lampwriter/battery7s6p/renders/bot_1oz_board_bottom.png

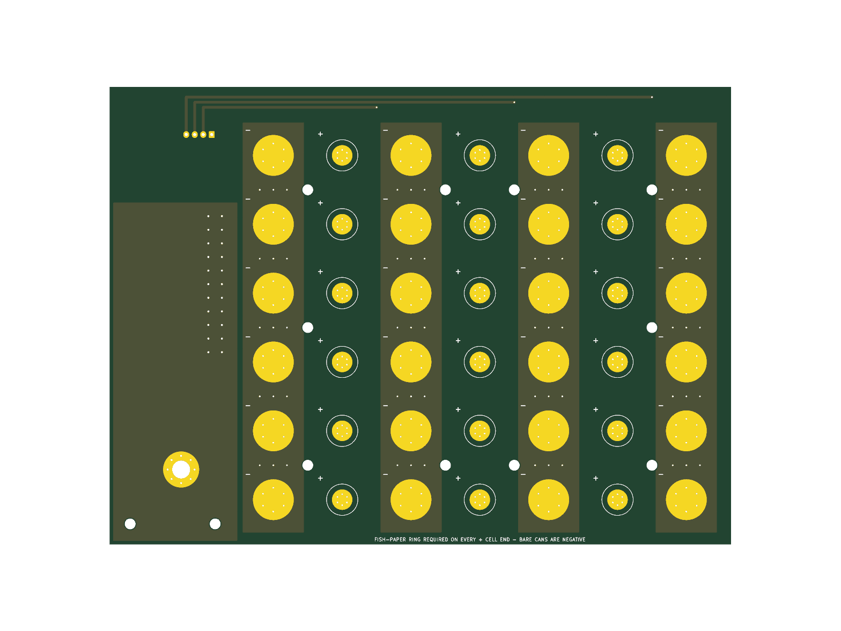
renders/bot_1oz_board_bottom.png
