lampwriter/battery7s6p/renders/bot_1oz_board_top.png

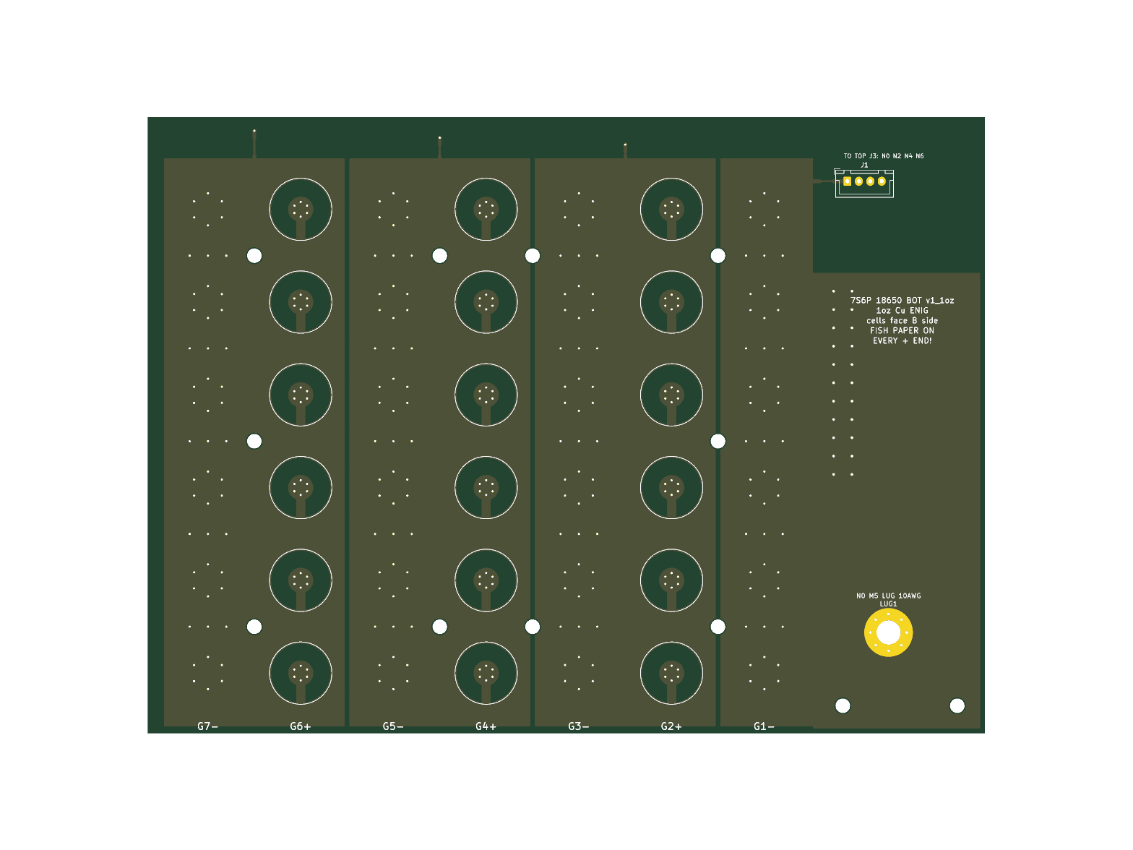
renders/bot_1oz_board_top.png
