lampwriter/battery7s6p/renders/bot_v12_board_bottom.png

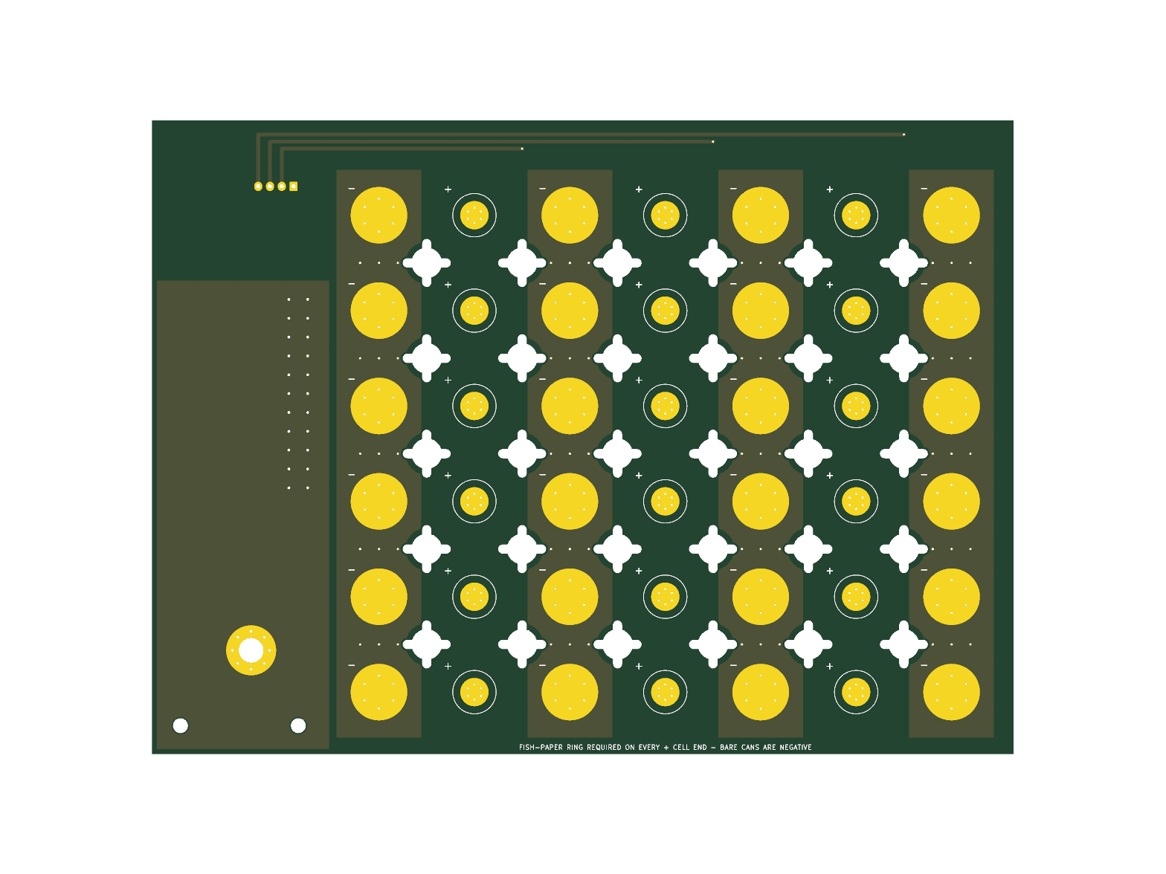
renders/bot_v12_board_bottom.png
