lampwriter/battery7s6p/renders/bot_v12_board_top.png

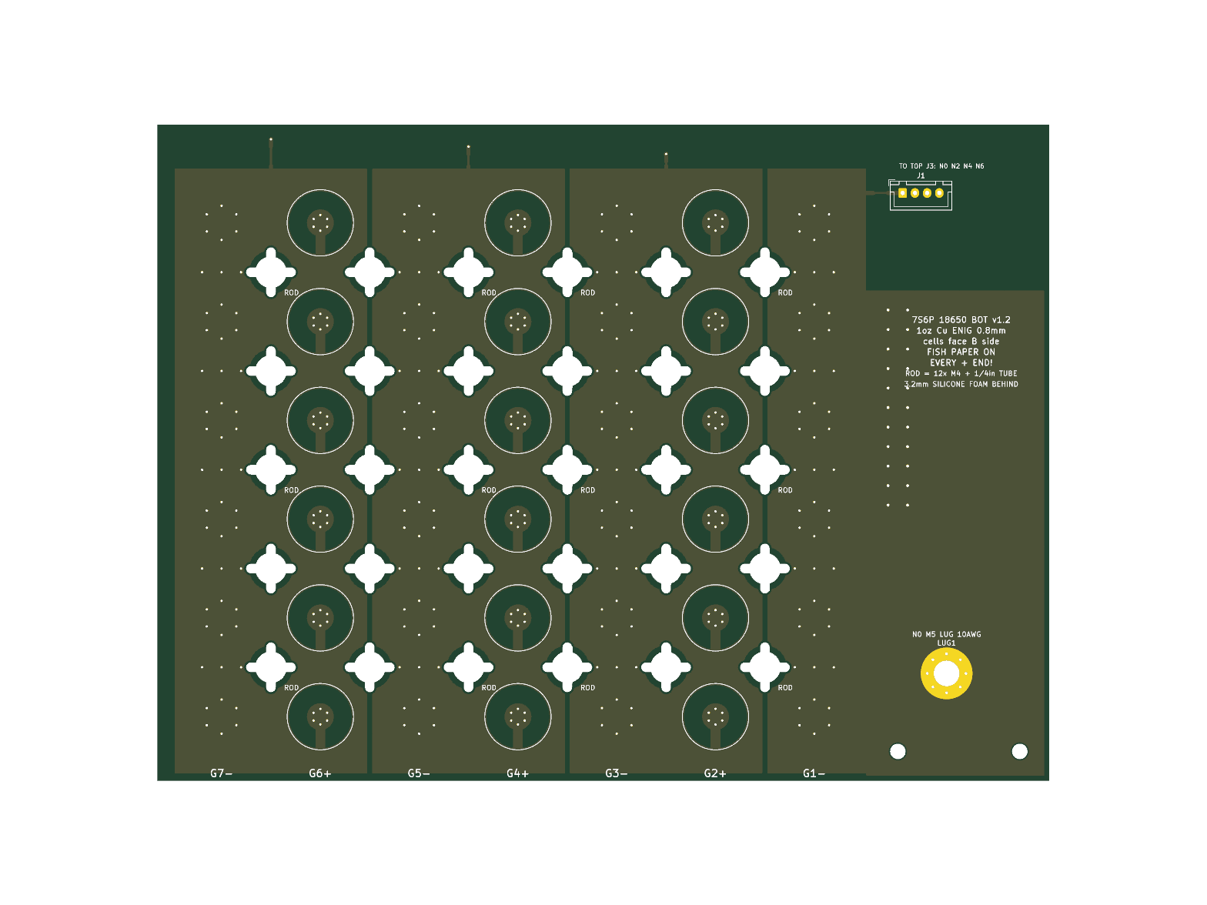
renders/bot_v12_board_top.png
