lampwriter/battery7s6p/renders/top_1oz_board_bottom.png

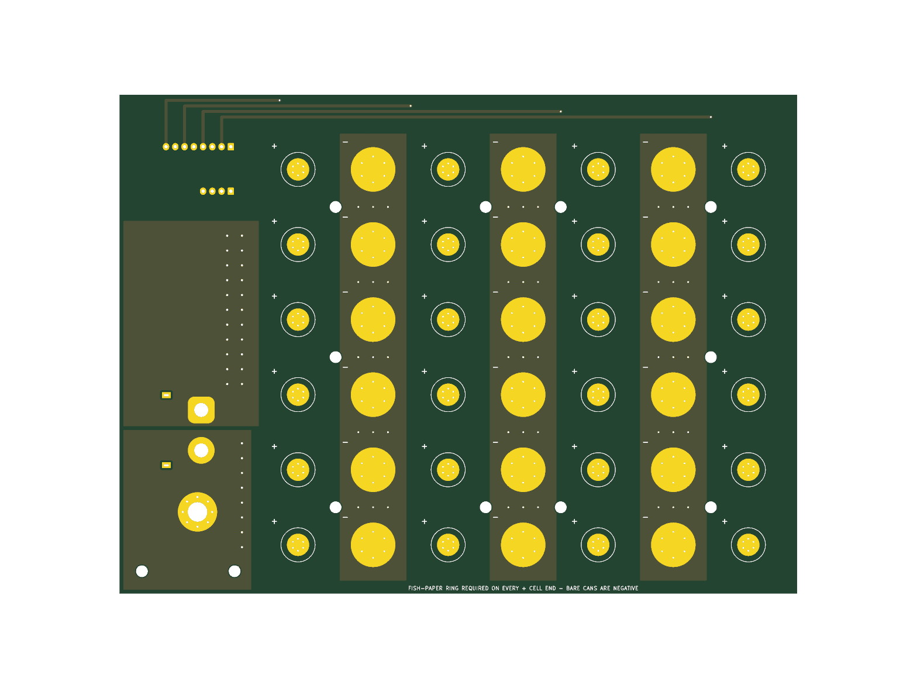
renders/top_1oz_board_bottom.png
