lampwriter/battery7s6p/renders/top_1oz_board_top.png

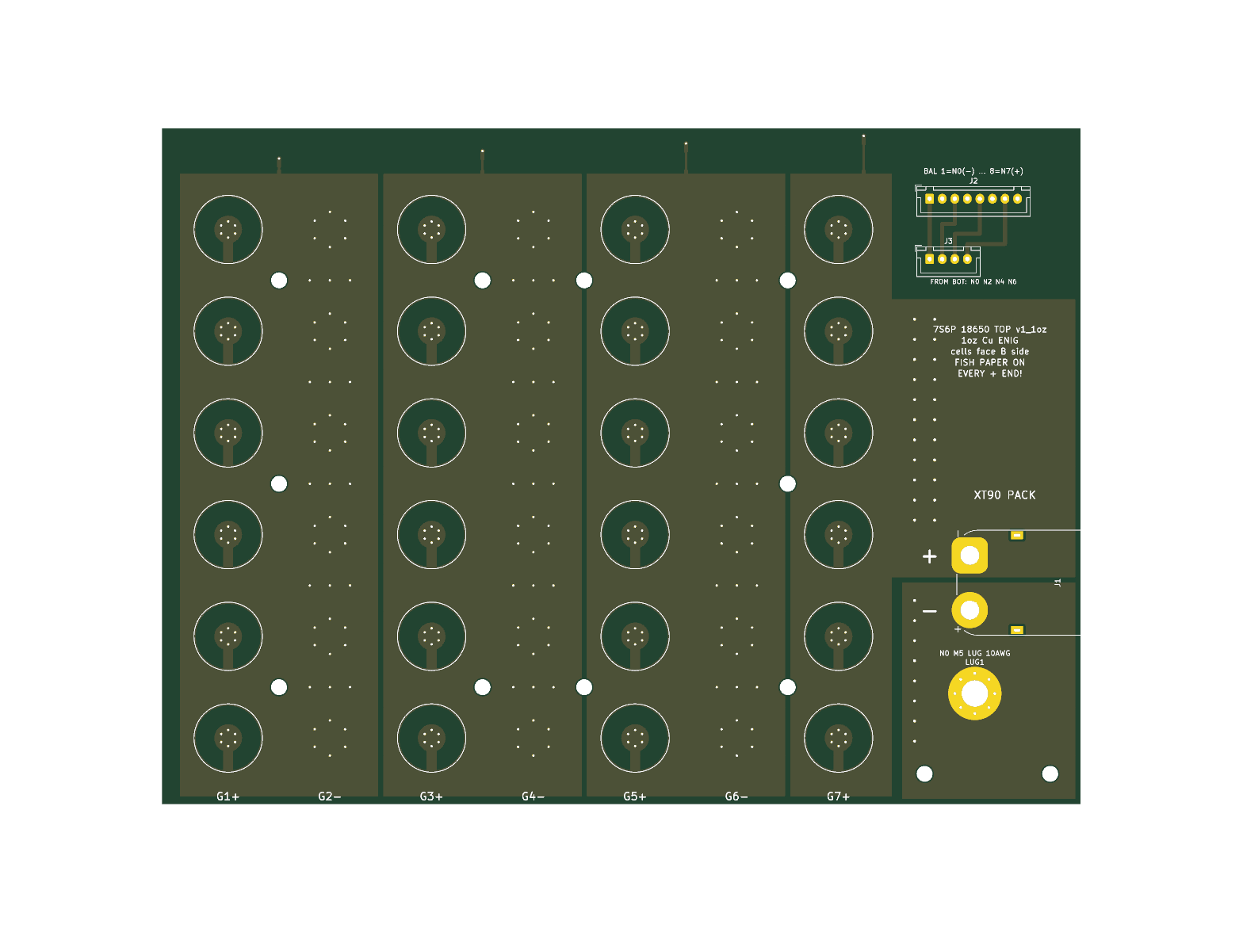
renders/top_1oz_board_top.png
