lampwriter/battery7s6p/renders/top_v12_board_bottom.png

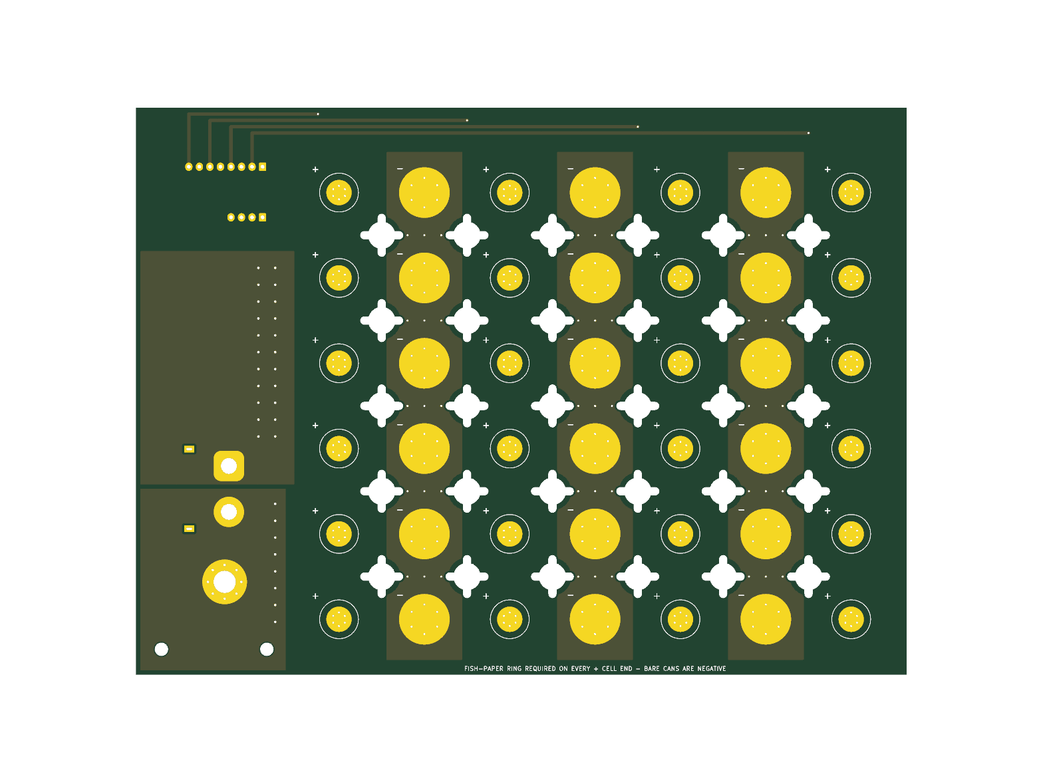
renders/top_v12_board_bottom.png
