lampwriter/battery7s6p/fab_v12/battery7s6p_bot_v12_BOM_JLCPCB.csv

Comment | Designator | Footprint | LCSC Part #
JST B4B-XH-A(LF)(SN) | J1 | JST_XH_B4B-XH-A_1x04_P2.50mm_Vertical | C144395
