lampwriter/battery7s6p/fab_v12/battery7s6p_top_v12_BOM_JLCPCB.csv

Comment | Designator | Footprint | LCSC Part #
AMASS XT90PW-M (XT90 PCB male, right-angle) | J1 | AMASS_XT90PW-M_1x02_P10.90mm_Horizontal | C3040689
JST B8B-XH-A(LF)(SN) | J2 | JST_XH_B8B-XH-A_1x08_P2.50mm_Vertical | C157972
JST B4B-XH-A(LF)(SN) | J3 | JST_XH_B4B-XH-A_1x04_P2.50mm_Vertical | C144395
