lampwriter/battery7s6p/fab_v12/battery7s6p_v12_drill_template.dxf

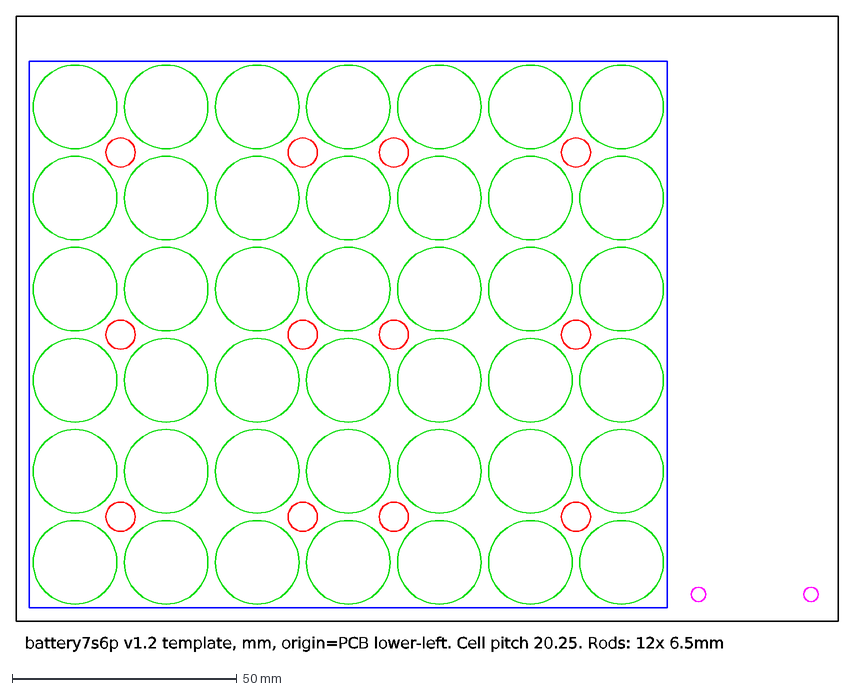
[picture p8: CAD file, 2026-11-01]
fab_v12/battery7s6p_v12_drill_template.dxf
battery7s6p v1.2 template, mm, origin=PCB lower-left. Cell pitch 20.25. Rods: 12x 6.5mm
