lampwriter/battery7s6p/bot_v12/battery7s6p_bot_v12.kicad_pcb

## KiCad design bot_v12/battery7s6p_bot_v12.kicad_pcb (2026-11-01)

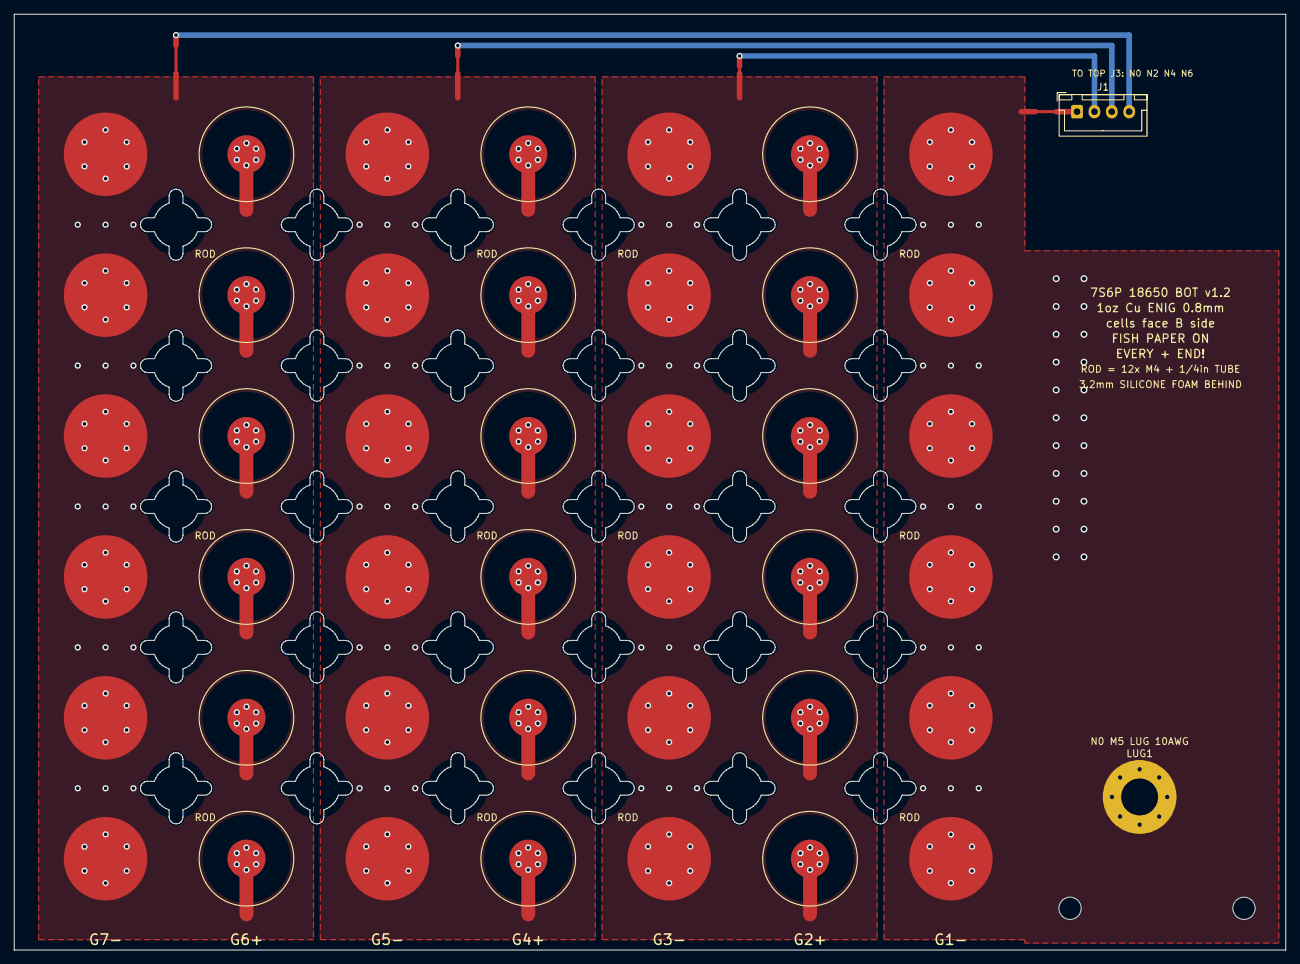
[picture p9: board battery7s6p_bot_v12.kicad_pcb from above]

Board: 2 copper layers, 182.8 x 134.5 mm, 46 parts (0 on the bottom side), 4 nets.

Parts:
C1_1, C1_2, C1_3, C1_4, C1_5, C1_6, C3_1, C3_2, C3_3, C3_4, C3_5, C3_6, C5_1, C5_2, C5_3, C5_4, C5_5, C5_6, C7_1, C7_2, C7_3, C7_4, C7_5, C7_6: 18650_NEG; CELL_NEG_CONTACT
C2_1, C2_2, C2_3, C2_4, C2_5, C2_6, C4_1, C4_2, C4_3, C4_4, C4_5, C4_6, C6_1, C6_2, C6_3, C6_4, C6_5, C6_6: 18650_POS; CELL_POS_CONTACT
HT0, HT1: MountingHole_3.2mm_M3
J1: B4B-XH-A to TOP; JST_XH_B4B-XH-A_1x04_P2.50mm_Vertical
LUG1: N0 M5 LUG; MountingHole_5.3mm_M5_Pad_Via

Connections:
N0: C1_1.1, C1_2.1, C1_3.1, C1_4.1, C1_5.1, C1_6.1, J1.1, LUG1.1
N2: C2_1.1, C2_2.1, C2_3.1, C2_4.1, C2_5.1, C2_6.1, C3_1.1, C3_2.1, C3_3.1, C3_4.1, C3_5.1, C3_6.1, J1.2
N4: C4_1.1, C4_2.1, C4_3.1, C4_4.1, C4_5.1, C4_6.1, C5_1.1, C5_2.1, C5_3.1, C5_4.1, C5_5.1, C5_6.1, J1.3
N6: C6_1.1, C6_2.1, C6_3.1, C6_4.1, C6_5.1, C6_6.1, C7_1.1, C7_2.1, C7_3.1, C7_4.1, C7_5.1, C7_6.1, J1.4
