lampwriter/battery7s6p/top_v12/battery7s6p_top_v12.kicad_pcb

## KiCad design top_v12/battery7s6p_top_v12.kicad_pcb (2026-11-01)

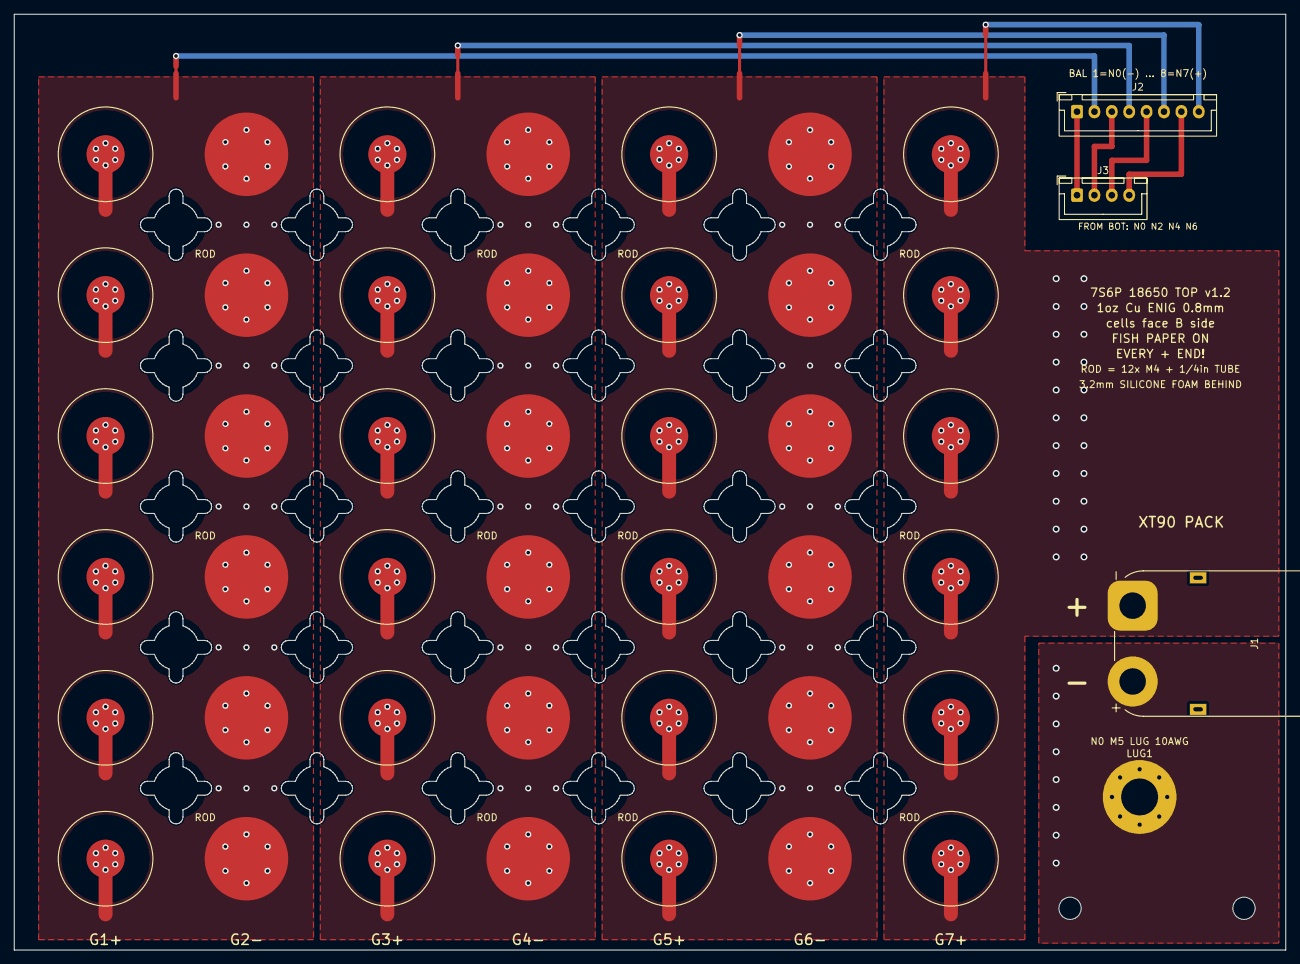
[picture p10: board battery7s6p_top_v12.kicad_pcb from above]

Board: 2 copper layers, 182.8 x 134.5 mm, 48 parts (0 on the bottom side), 9 nets.

Parts:
C1_1, C1_2, C1_3, C1_4, C1_5, C1_6, C3_1, C3_2, C3_3, C3_4, C3_5, C3_6, C5_1, C5_2, C5_3, C5_4, C5_5, C5_6, C7_1, C7_2, C7_3, C7_4, C7_5, C7_6: 18650_POS; CELL_POS_CONTACT
C2_1, C2_2, C2_3, C2_4, C2_5, C2_6, C4_1, C4_2, C4_3, C4_4, C4_5, C4_6, C6_1, C6_2, C6_3, C6_4, C6_5, C6_6: 18650_NEG; CELL_NEG_CONTACT
HT0, HT1: MountingHole_3.2mm_M3
J1: XT90PW-M; AMASS_XT90PW-M_1x02_P10.90mm_Horizontal
J2: B8B-XH-A BAL; JST_XH_B8B-XH-A_1x08_P2.50mm_Vertical
J3: B4B-XH-A from BOT; JST_XH_B4B-XH-A_1x04_P2.50mm_Vertical
LUG1: N0 M5 LUG; MountingHole_5.3mm_M5_Pad_Via

Connections:
N0: J1.2, LUG1.1
N0_SENSE: J2.1, J3.1
N1: C1_1.1, C1_2.1, C1_3.1, C1_4.1, C1_5.1, C1_6.1, C2_1.1, C2_2.1, C2_3.1, C2_4.1, C2_5.1, C2_6.1, J2.2
N2: J2.3, J3.2
N3: C3_1.1, C3_2.1, C3_3.1, C3_4.1, C3_5.1, C3_6.1, C4_1.1, C4_2.1, C4_3.1, C4_4.1, C4_5.1, C4_6.1, J2.4
N4: J2.5, J3.3
N5: C5_1.1, C5_2.1, C5_3.1, C5_4.1, C5_5.1, C5_6.1, C6_1.1, C6_2.1, C6_3.1, C6_4.1, C6_5.1, C6_6.1, J2.6
N6: J2.7, J3.4
N7: C7_1.1, C7_2.1, C7_3.1, C7_4.1, C7_5.1, C7_6.1, J1.1, J2.8
