lampwriter/battery7s6p/(commit log)

2026-10-28 Add v1 7S6P 18650 battery module (KiCad 9, 20.25 mm pitch)
    Import the top and bottom KiCad projects, generator and export scripts,
    fuse calculation, JLCPCB fabrication outputs, and board renders.
    [battery7s6p_bot-B_Cu.gbr, battery7s6p_bot-B_Mask.gbr, battery7s6p_bot-B_Paste.gbr, battery7s6p_bot-B_Silkscreen.gbr, battery7s6p_bot-Edge_Cuts.gbr, battery7s6p_bot-F_Cu.gbr, battery7s6p_bot-F_Mask.gbr, battery7s6p_bot-F_Paste.gbr]
2026-10-29 v1.1: add 1 oz copper variant
    [battery7s6p_bot_1oz-B_Cu.gbr, battery7s6p_bot_1oz-B_Mask.gbr, battery7s6p_bot_1oz-B_Paste.gbr, battery7s6p_bot_1oz-B_Silkscreen.gbr, battery7s6p_bot_1oz-Edge_Cuts.gbr, battery7s6p_bot_1oz-F_Cu.gbr, battery7s6p_bot_1oz-F_Mask.gbr, battery7s6p_bot_1oz-F_Paste.gbr]
2026-11-01 v1.2: pressure-contact clamp design
    [battery7s6p_bot_1oz.kicad_pcb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]
